LucaLanzi/BILLEE-Hardware-2025-2026/README.md

# BILLEE URC 2025/2026 Hardware Architecture Design and Controller Board Implementation
An attempt at integrating a rover controller board to meet the URC 2026 Guidelines

Migrated to
https://github.com/orgs/BroncoSpace-BILLEE/repositories

This repo is now deprecated
