LucaLanzi/BILLEE-Hardware-2025-2026/(commit log)

2026-02-24 Science controller script for Jetson
    Science Module has various devices that need to be controlled via a menu system. These files serialize this process for the Nvidia Jetson and every component can be easily controlled and accessed via the tty terminal through this python script.
2026-02-24 Update sciencecontrol.ino
    Implemented fix for Servos
    [sciencecontrol.ino]
2026-02-25 Added EStop in code and Schematic
    [mercury-1.kicad_sch, science.kicad_sch]
2026-02-26 updated servo
